danny014789/Peltier/Core/Src/main.c

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
/* Includes ------------------------------------------------------------------*/
#include "main.h"
#include "usb_device.h"

/* USER CODE BEGIN Includes */
#include "control.h"
#include "cli.h"
#include "usbd_cdc_if.h"
/* USER CODE END Includes */

ADC_HandleTypeDef hadc1;

TIM_HandleTypeDef htim1;
TIM_HandleTypeDef htim3;

void SystemClock_Config(void);
static void MX_GPIO_Init(void);
static void MX_ADC1_Init(void);
static void MX_TIM1_Init(void);
static void MX_TIM3_Init(void);
void HAL_TIM_MspPostInit(TIM_HandleTypeDef *htim);
/**
  * @brief  The application entry point.
  * @retval int
  */
int main(void)
{
  /* MCU Configuration--------------------------------------------------------*/

  /* Reset of all peripherals, Initializes the Flash interface and the Systick. */
  HAL_Init();

  /* Configure the system clock */
  SystemClock_Config();

  /* USER CODE BEGIN SysInit */
  /* USB re-enumeration trick:
   * Many "Blue Pill" boards ship with a wrong-value D+ pull-up (R10 = 10k
   * instead of 1.5k), so the host doesn't reliably detect insertion.
   * Driving PA12 (D+) low for ~50 ms then releasing forces the host to
   * see a fresh attachment and re-enumerate.  The USB peripheral takes
   * over PA12 again once MX_USB_DEVICE_Init() runs.
   */
  {
    GPIO_InitTypeDef gpio = {0};
    __HAL_RCC_GPIOA_CLK_ENABLE();
    gpio.Pin   = GPIO_PIN_12;
    gpio.Mode  = GPIO_MODE_OUTPUT_PP;
    gpio.Pull  = GPIO_NOPULL;
    gpio.Speed = GPIO_SPEED_FREQ_HIGH;
    HAL_GPIO_Init(GPIOA, &gpio);
    HAL_GPIO_WritePin(GPIOA, GPIO_PIN_12, GPIO_PIN_RESET);
    HAL_Delay(50);
    /* Release PA12 back to floating input so the USB peripheral can drive it. */
    gpio.Mode = GPIO_MODE_INPUT;
    gpio.Pull = GPIO_NOPULL;
    HAL_GPIO_Init(GPIOA, &gpio);
  }
  /* USER CODE END SysInit */

  /* Initialize all configured peripherals */
  MX_GPIO_Init();
  MX_ADC1_Init();
  MX_TIM1_Init();
  MX_TIM3_Init();
  MX_USB_DEVICE_Init();
  /* USER CODE BEGIN 2 */
  /* === USB ENUMERATION ISOLATION TEST ===
   * Temporarily disabling Control_Init() (TIM3 50 Hz IRQ + ADC polling) and
   * CLI_Init() (USB CDC banner print) to test whether the PID code is
   * interfering with USB enumeration.  The MCU still inits USB and blinks
   * the LED in the main loop so we know firmware is alive.
   *
   * If USB enumerates with this build, the bug is somewhere in our 50 Hz
   * loop or its setup.  If it STILL doesn't enumerate, the problem is at
   * a lower level (clock precision, peripheral state, board-specific).
   *
   * Restore the two lines below once we've used this datapoint.
   */
  /* Control_Init(); */
  /* CLI_Init();     */
  /* USER CODE END 2 */

  /* Infinite loop */
  /* USER CODE BEGIN WHILE */
  while (1)
  {
    HAL_GPIO_TogglePin(STATUS_LED_GPIO_Port, STATUS_LED_Pin);
    HAL_Delay(250);   /* 2 Hz blink in main loop, no IRQ used */
    /* CLI_Process();          */
    /* CLI_StreamTelemetry();  */
    /* USER CODE END WHILE */

    /* USER CODE BEGIN 3 */
  }
  /* USER CODE END 3 */
}

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
/* USER CODE BEGIN 4 */

/**
  * @brief HAL period-elapsed callback dispatcher
  */
void HAL_TIM_PeriodElapsedCallback(TIM_HandleTypeDef *htim)
{
  if (htim->Instance == TIM3)
  {
    Control_Tick50Hz();
  }
}

/* USER CODE END 4 */
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
