danny014789/Peltier/Peltier.ioc

Mcu.UserName=STM32F103C8Tx
PA0-WKUP.Signal=ADCx_IN0
PA11.Signal=USB_DM
PA12.Signal=USB_DP
PA13.Signal=SYS_JTMS-SWDIO
PA14.Signal=SYS_JTCK-SWCLK
PA8.GPIO_Label=DRV592_INp
PA8.Signal=S_TIM1_CH1
PA9.GPIO_Label=DRV592_INn
PA9.Signal=S_TIM1_CH2
PB0.GPIO_Label=DRV592_SHUTDOWN
PB0.Signal=GPIO_Output
PB1.GPIO_Label=DRV592_HIZ
PB1.Signal=GPIO_Output
PB10.GPIO_Label=DRV592_FAULT0
PB10.Signal=GPIO_Input
PB11.GPIO_Label=DRV592_FAULT1
PB11.Signal=GPIO_Input
PC13-TAMPER-RTC.GPIO_Label=STATUS_LED
PC13-TAMPER-RTC.Signal=GPIO_Output
PC14-OSC32_IN.Signal=RCC_OSC32_IN
PC15-OSC32_OUT.Signal=RCC_OSC32_OUT
PD0-OSC_IN.Signal=RCC_OSC_IN
PD1-OSC_OUT.Signal=RCC_OSC_OUT
