danny014789/Peltier/Core/Inc/main.h

#define STATUS_LED_Pin              GPIO_PIN_13
#define STATUS_LED_GPIO_Port        GPIOC
#define NTC_ADC_Pin                 GPIO_PIN_0
#define NTC_ADC_GPIO_Port           GPIOA
#define DRV592_INp_Pin              GPIO_PIN_8
#define DRV592_INp_GPIO_Port        GPIOA
#define DRV592_INn_Pin              GPIO_PIN_9
#define DRV592_INn_GPIO_Port        GPIOA
#define DRV592_SHUTDOWN_Pin         GPIO_PIN_0
#define DRV592_SHUTDOWN_GPIO_Port   GPIOB
#define DRV592_HIZ_Pin              GPIO_PIN_1
#define DRV592_HIZ_GPIO_Port        GPIOB
#define DRV592_FAULT0_Pin           GPIO_PIN_10
#define DRV592_FAULT0_GPIO_Port     GPIOB
#define DRV592_FAULT1_Pin           GPIO_PIN_11
#define DRV592_FAULT1_GPIO_Port     GPIOB
