danny014789/Peltier/(commit log)

2026-04-25 Initial commit: Peltier PID temperature controller
    STM32F103C8 closed-loop temperature control of a Peltier driven by a
    TI DRV592 H-bridge, sensed via a Semitec 103JT NTC. PID runs at 50 Hz
    from TIM3 IRQ; user commands and 10 Hz telemetry over USB CDC.
    Modules under Core/{Inc,Src}: ntc, pid, peltier, control, cli.
    TIM1 emits 20 kHz complementary PWM on PA8/PA9 to DRV592 IN+/IN-.
    ADC prescaler corrected to /4 (12 MHz) to stay within F103 spec.
    [Peltier.ioc, cli.c, cli.h, control.c, control.h, main.c, main.h, ntc.c]
2026-04-25 Enable HAL ADC and TIM modules; fix cli.c indentation
    stm32f1xx_hal_conf.h had ADC and TIM modules commented out (only PCD
    was on, from the original USB-only generation), causing every HAL TIM
    or ADC type to be undefined at compile time. Uncomment both.
    Also splits a fused if-statement in append_f3 that was generating a
    misleading-indentation warning.
    [cli.c]
2026-04-25 Add ADC HAL driver source/headers
    The original CubeMX generation only copied HAL drivers for the modules
    in use at the time (PCD/GPIO/RCC/etc.), so stm32f1xx_hal_adc.{c,h} and
    stm32f1xx_hal_adc_ex.{c,h} were missing. Pulled them from the FW_F1
    V1.8.4 repository to match the rest of the HAL bundle. TIM HAL was
    already present.
2026-04-25 Declare HAL_TIM_MspPostInit prototype in main.c
    Silences the implicit-declaration warning when main.c calls
    HAL_TIM_MspPostInit from MX_TIM1_Init. Function is defined in
    stm32f1xx_hal_msp.c; only the visibility was missing.
    [main.c]
2026-04-30 Pulse D+ low at boot to force USB re-enumeration
    Common workaround for Blue Pill boards that ship with a wrong-value
    (10k instead of 1.5k) D+ pull-up, where the host fails to detect the
    device on power-up. Briefly drives PA12 low so the host sees a fresh
    attachment when the USB peripheral takes the pin back during
    MX_USB_DEVICE_Init.
    [main.c]
2026-04-30 Bump status LED heartbeat to 2 Hz
    Faster blink makes it easier to confirm at a glance that the new
    firmware is actually running on the chip after re-flashing.
2026-04-30 Release PA12 to input after D+ pulse trick
    Leaving PA12 as a push-pull GPIO output can fight with the USB
    peripheral when MX_USB_DEVICE_Init runs, on at least some F1 silicon
    revisions. After the 50 ms low pulse, hand the pin back to floating
    input before USB takes over.
2026-04-30 TEST: minimal USB-only build for enumeration isolation
    Temporarily disables Control_Init (TIM3 IRQ + ADC poll) and CLI_Init
    (USB CDC banner) to test whether our PID loop is preventing the host
    from completing USB enumeration. LED still blinks at 2 Hz from the
    main loop so the user can confirm firmware is alive.
    This commit is meant to be reverted once we have the answer.
    [main.c]
